Cyberax/ZunoSomfy/media/IMG_20190609_013129.jpg

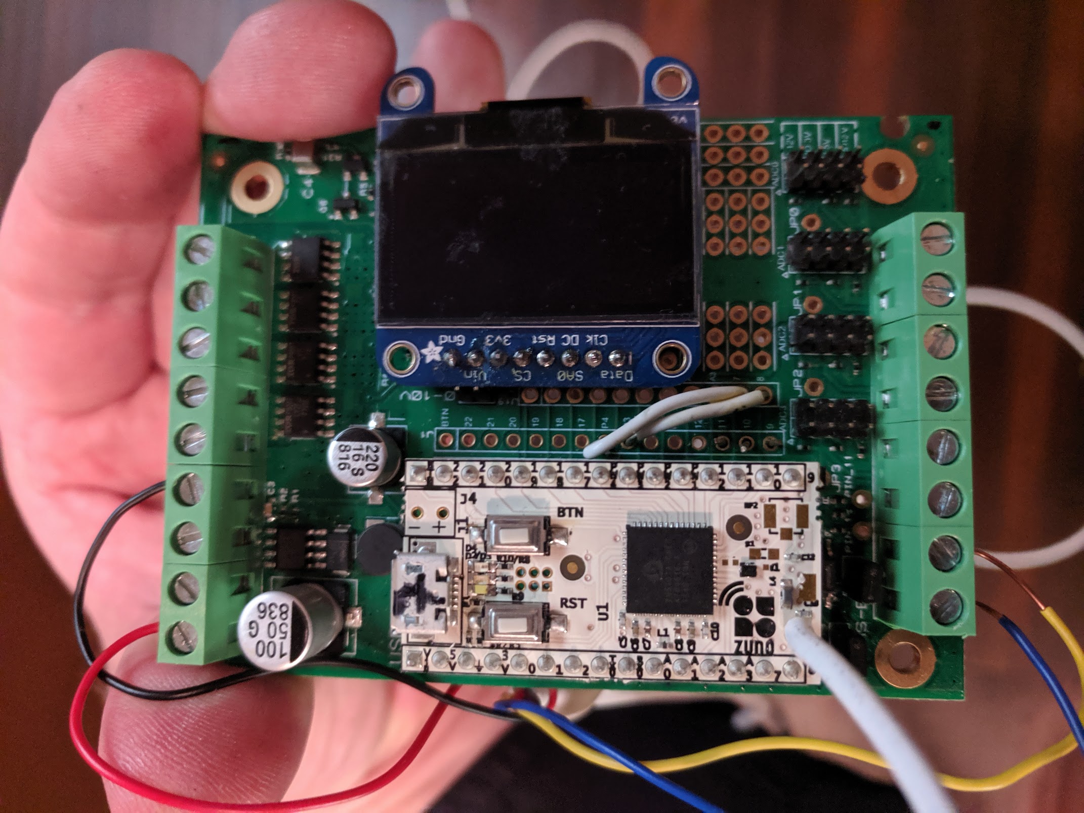
media/IMG_20190609_013129.jpg
