Cyberax/ZunoSomfy/media/IMG_20190621_151035.jpg

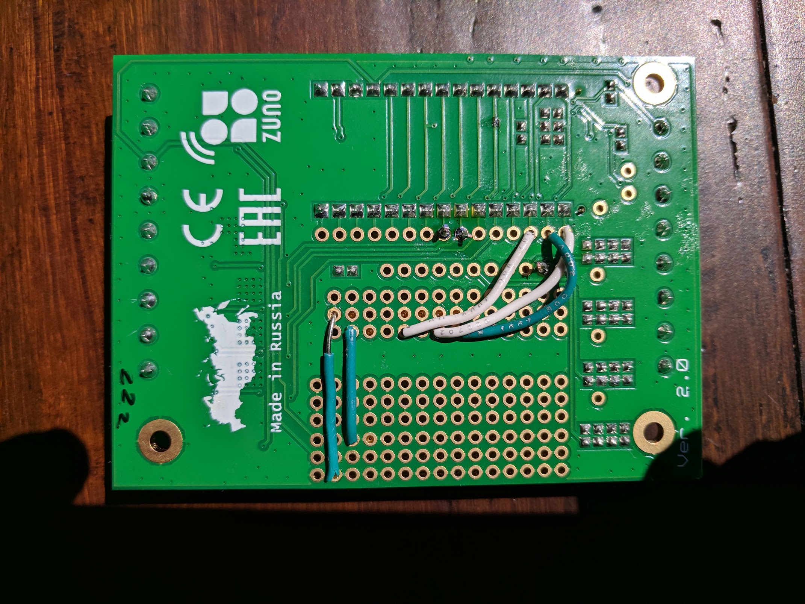
media/IMG_20190621_151035.jpg
