Cyberax/ZunoSomfy/media/IMG_20190621_151029.jpg

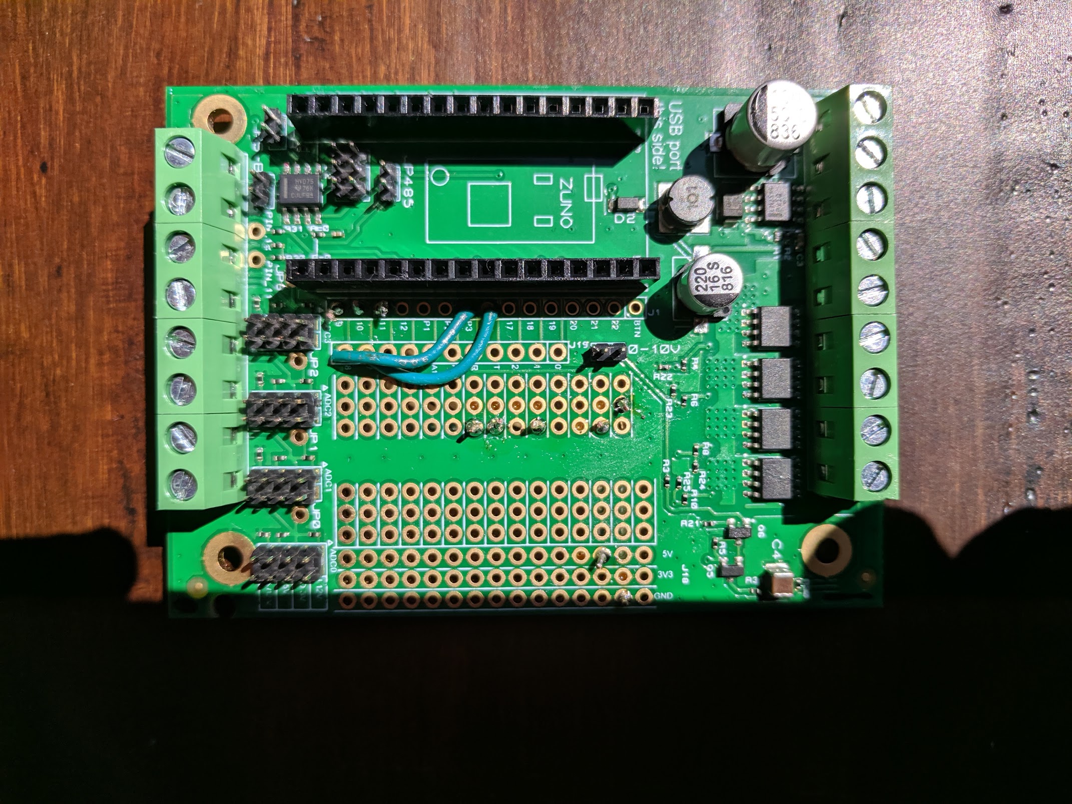
media/IMG_20190621_151029.jpg
