Cyberax/ZunoSomfy/(commit log)

2019-06-08 Robustness improvements
    Added several timers to save the OLED exposure time, respect the unsolicited
    report timeout and handle stuck/timed out shades.
    [Logic.cpp]
2019-06-23 Correctly detect the change
    [Logic.cpp]
