Cyberax/ZunoSomfy/(notices)

Notices in the files:
FixedOled.cpp:
modify it under the terms of the CC BY-NC-SA 3.0 license.
